Aryanbrb/Specter/LICENSING.md

# Dolivo licensing

Copyright 2026 the Dolivo (formerly Specter) contributors. Source location: https://github.com/Aryanbrb/Specter

Dolivo's original hardware design sources, including the KiCad schematic, PCB, project configuration, original footprint geometry and hardware design data in the BOM, are licensed under [CERN Open Hardware Licence Version 2 – Weakly Reciprocal](LICENSES/CERN-OHL-W-2.0.txt) (SPDX identifier `CERN-OHL-W-2.0`). This licence permits making, modifying and selling products. When distributing covered modifications or products, follow the licence's notice and source-availability terms. Preserve this notice with redistributed source.

Dolivo's original explanatory material, including the README, release checklist, assembly notes and BOM commentary, is licensed under [Creative Commons Attribution 4.0 International](LICENSES/CC-BY-4.0.txt) (SPDX identifier `CC-BY-4.0`). Credit the Dolivo contributors, link to the source and licence, and indicate changes.

## Third-party material

- The two STEP models in [3dmodels](3dmodels/README.md) come from Raspberry Pi's RP2350B Minimal reference design and retain its [MIT licence and disclaimer](3dmodels/LICENSE-Raspberry-Pi.txt).
- KiCad library data embedded in the design retains the [KiCad library licence and design exception](https://www.kicad.org/libraries/license/). Review separately distributed library items for upstream notices.
- The RP2350B, flash, PSRAM and other purchased parts are third-party components. Dolivo's hardware grant covers the module design the contributors control. Supplier datasheets, marks and underlying chip designs remain with their respective owners.
- No Dolivo firmware is included in this revision. Identify the software licence, dependencies and build instructions when introducing firmware.
