Aryanbrb/Specter/3dmodels/abracon_aota-b201610s3r3-101-t.step

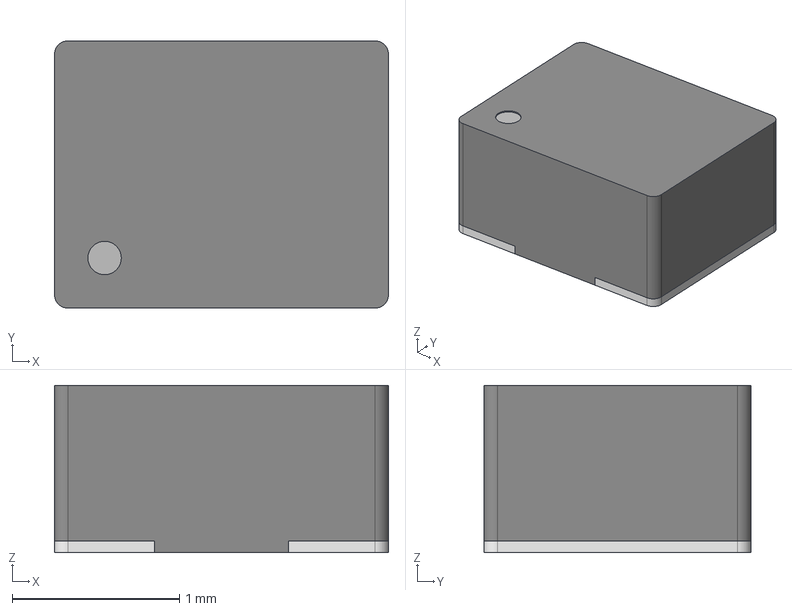
[picture p1: CAD file, 2026-11-12]
3dmodels/abracon_aota-b201610s3r3-101-t.step
2.00 x 1.60 x 1.00 mm
Pins
Pin1Indicator
