Aryanbrb/Specter/3dmodels/rpi_rp2350b.step

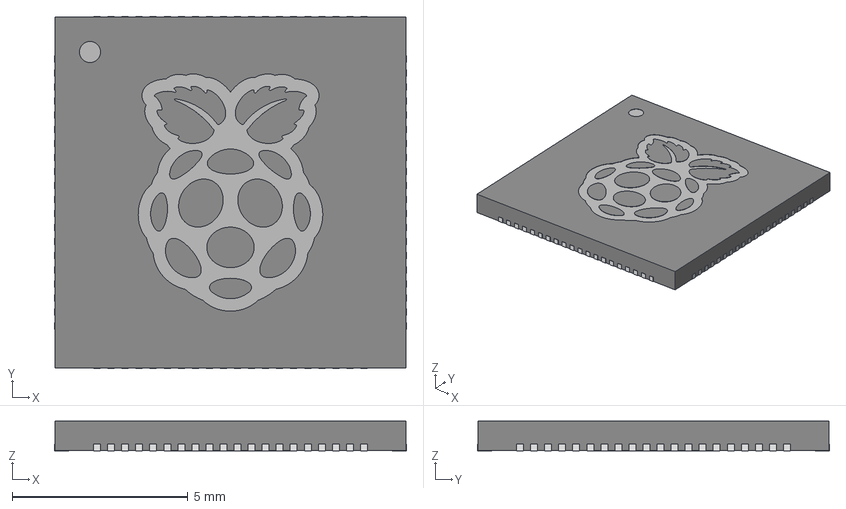
[picture p2: CAD file, 2026-11-12]
3dmodels/rpi_rp2350b.step
10.0 x 10.0 x 0.85 mm
Package
EP
Pin1Indicator
Pins
Logo
