Aryanbrb/Specter/Dolivo.kicad_pcb

## KiCad design Dolivo.kicad_pcb (2026-11-12)

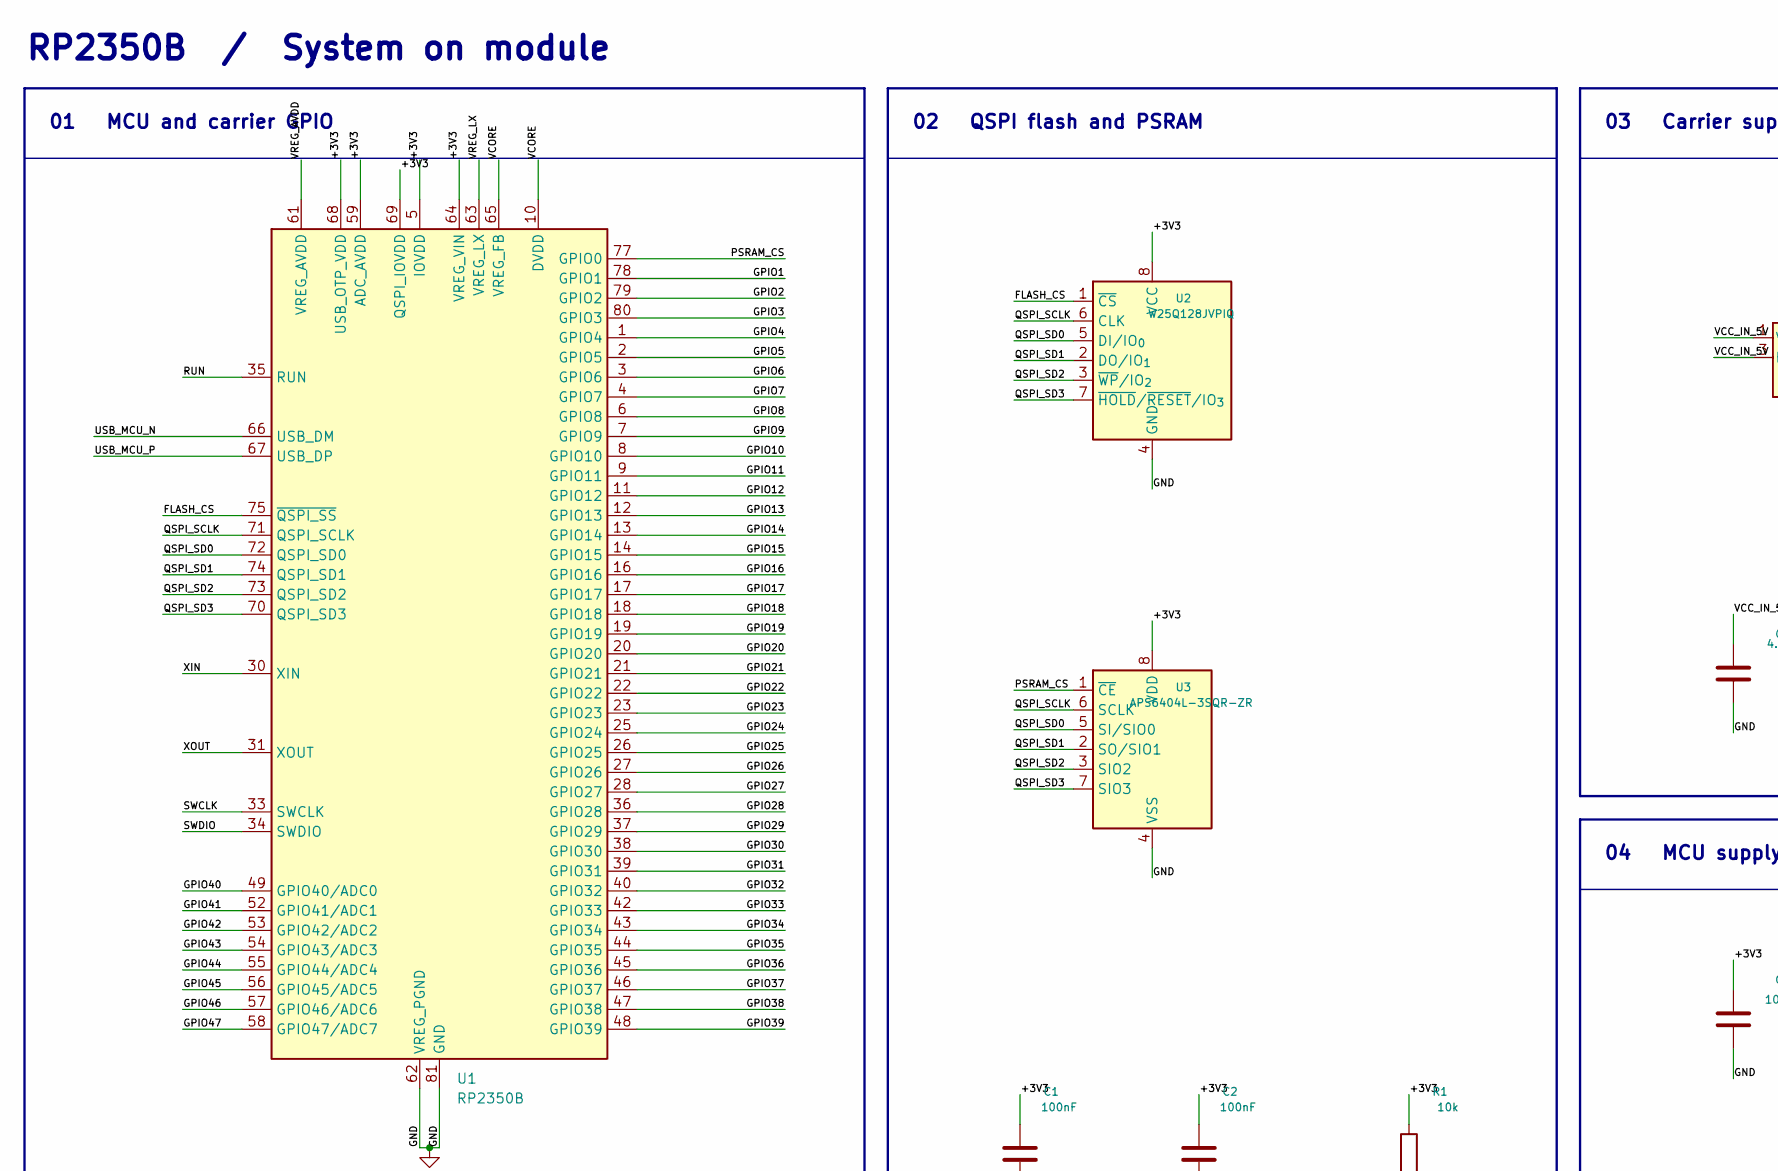
[picture p3: schematic Dolivo.kicad_sch, Dolivo RP2350B SoM, part in row 1, column 1]

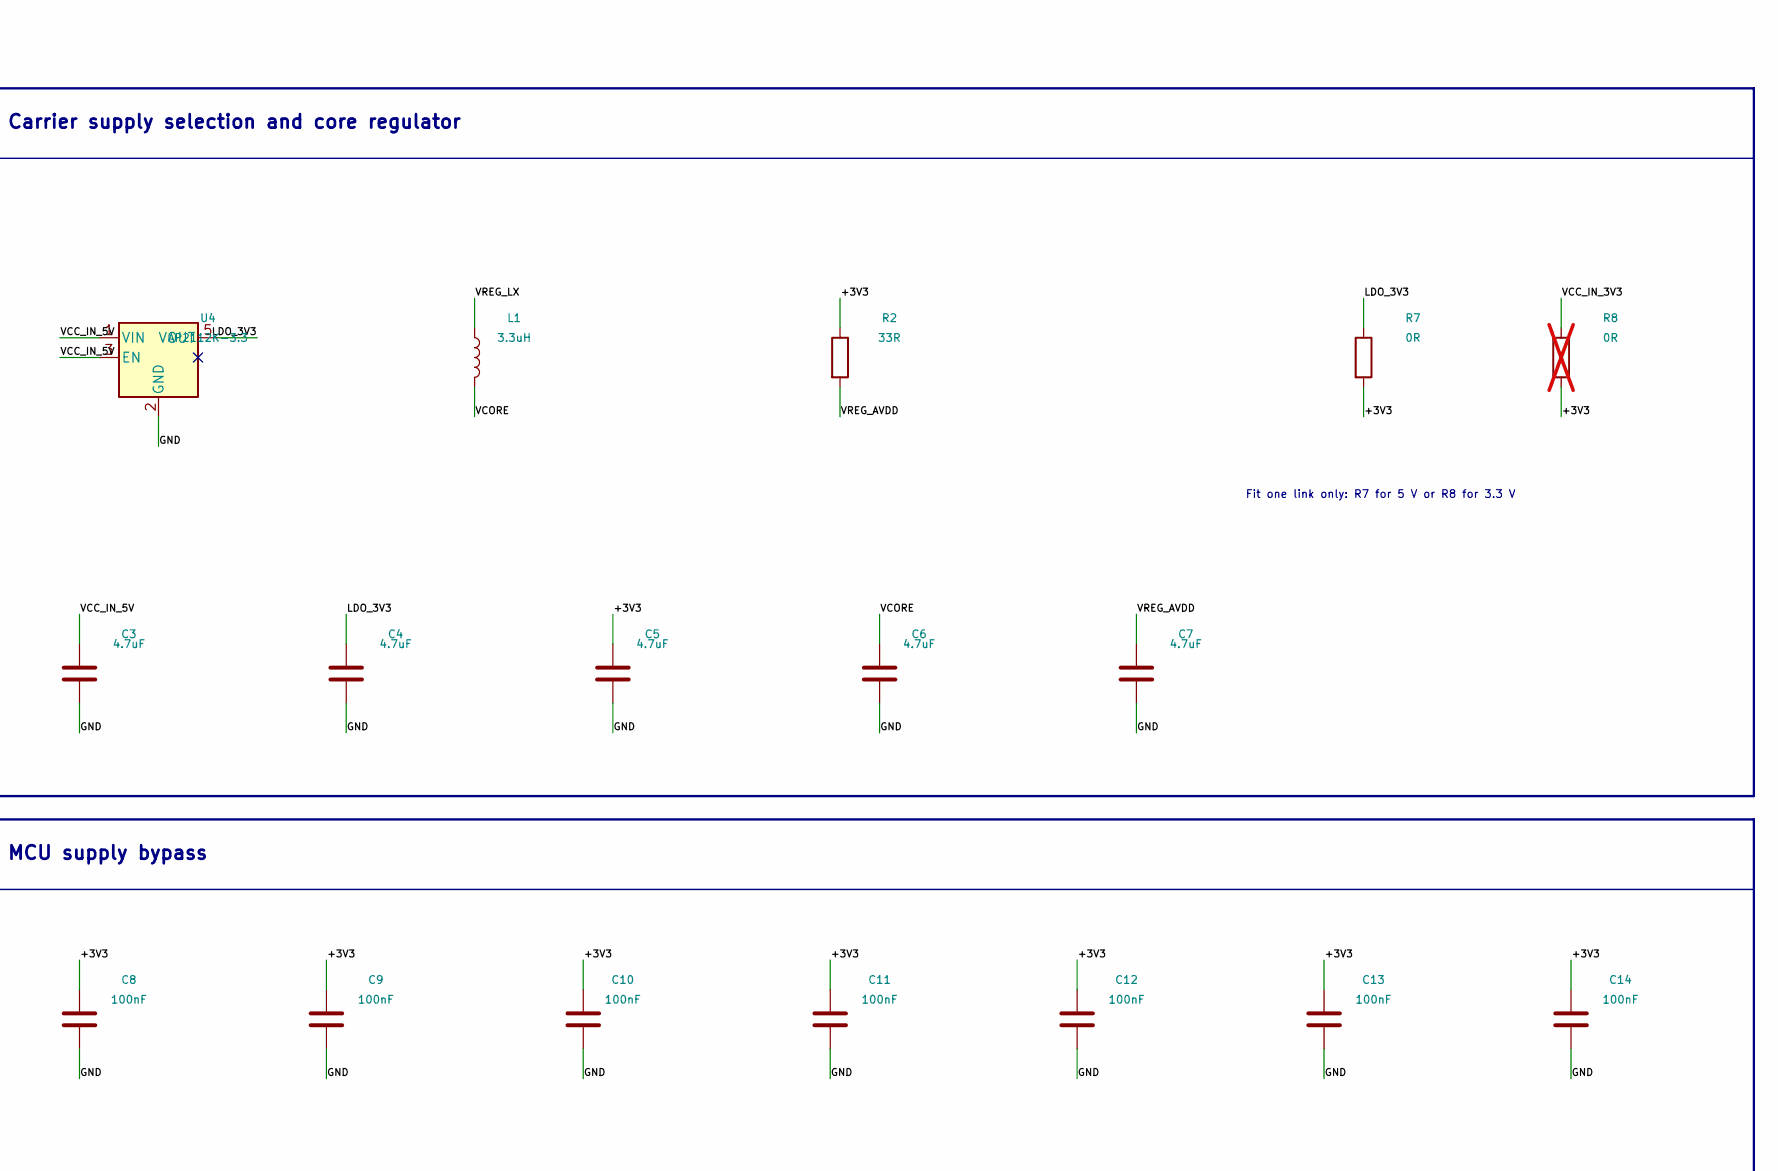
[picture p4: schematic Dolivo.kicad_sch, Dolivo RP2350B SoM, part in row 1, column 2]

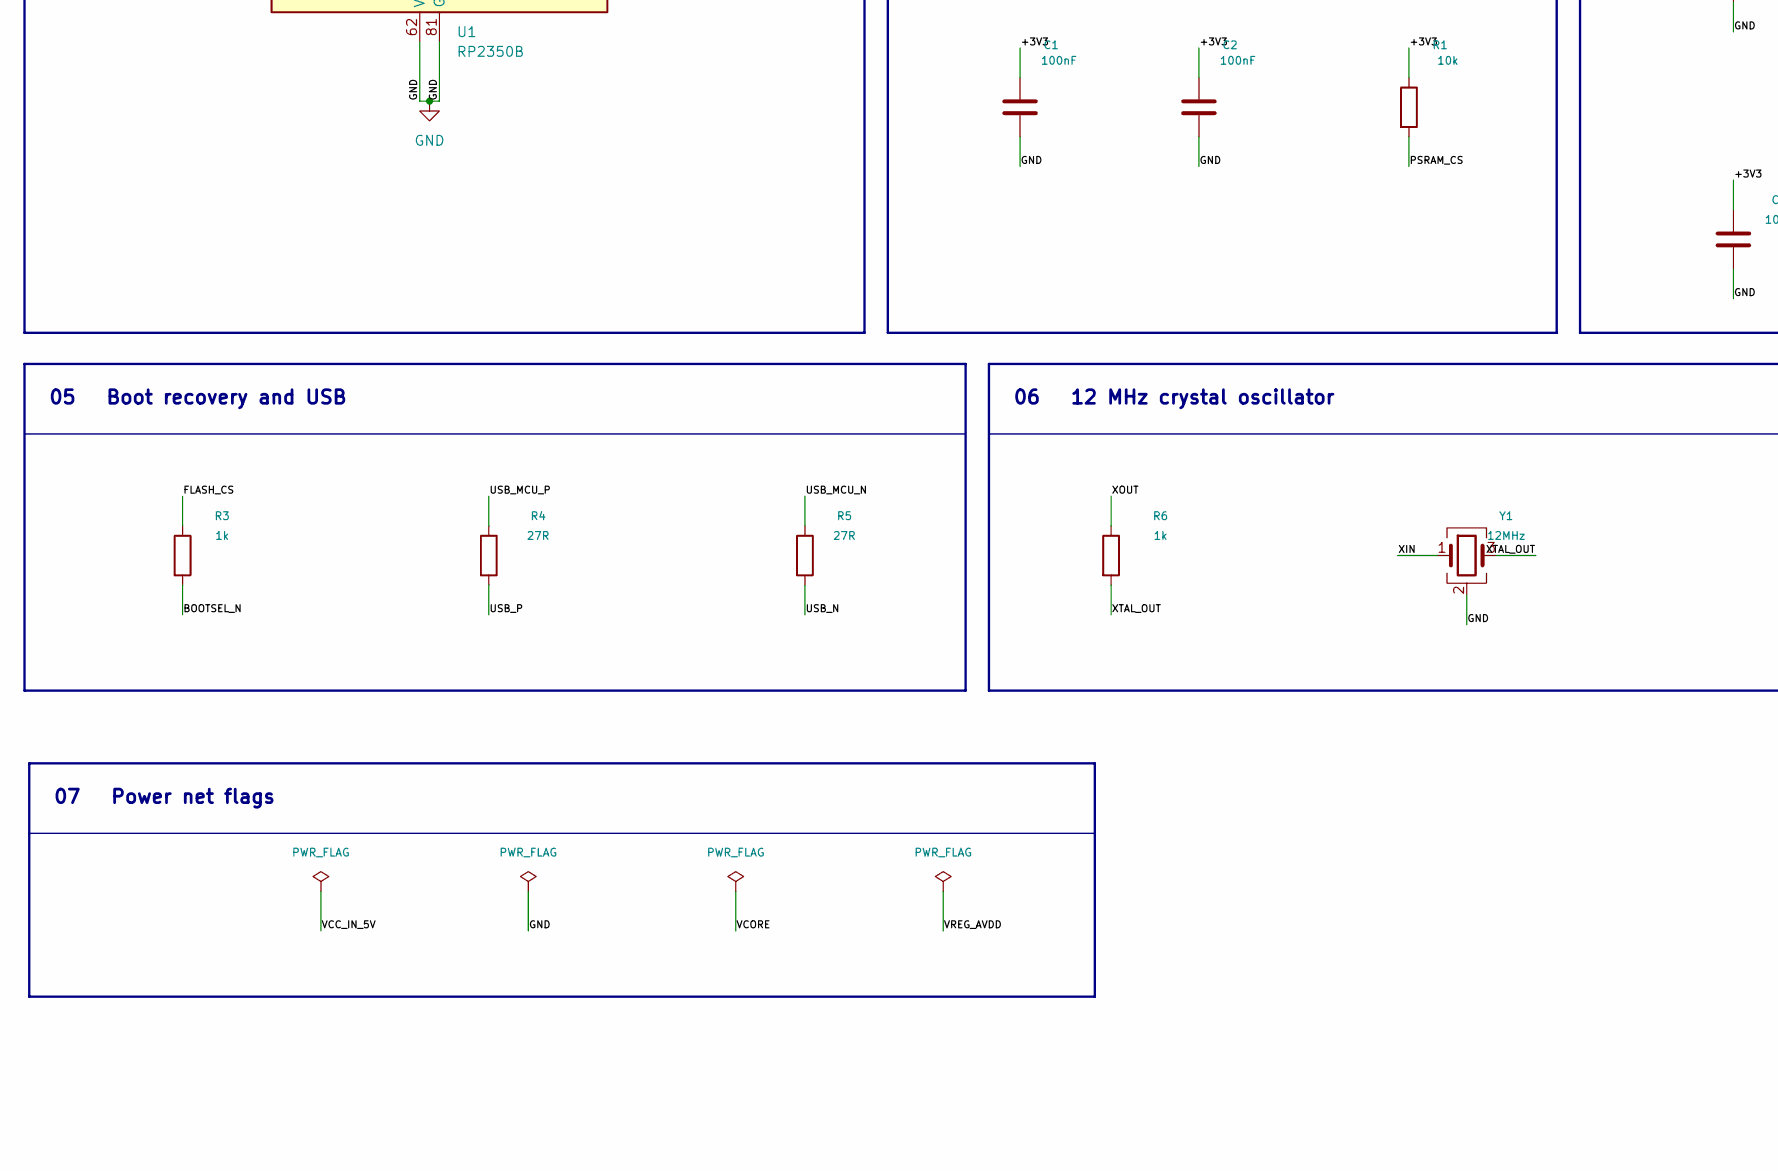
[picture p5: schematic Dolivo.kicad_sch, Dolivo RP2350B SoM, part in row 2, column 1]

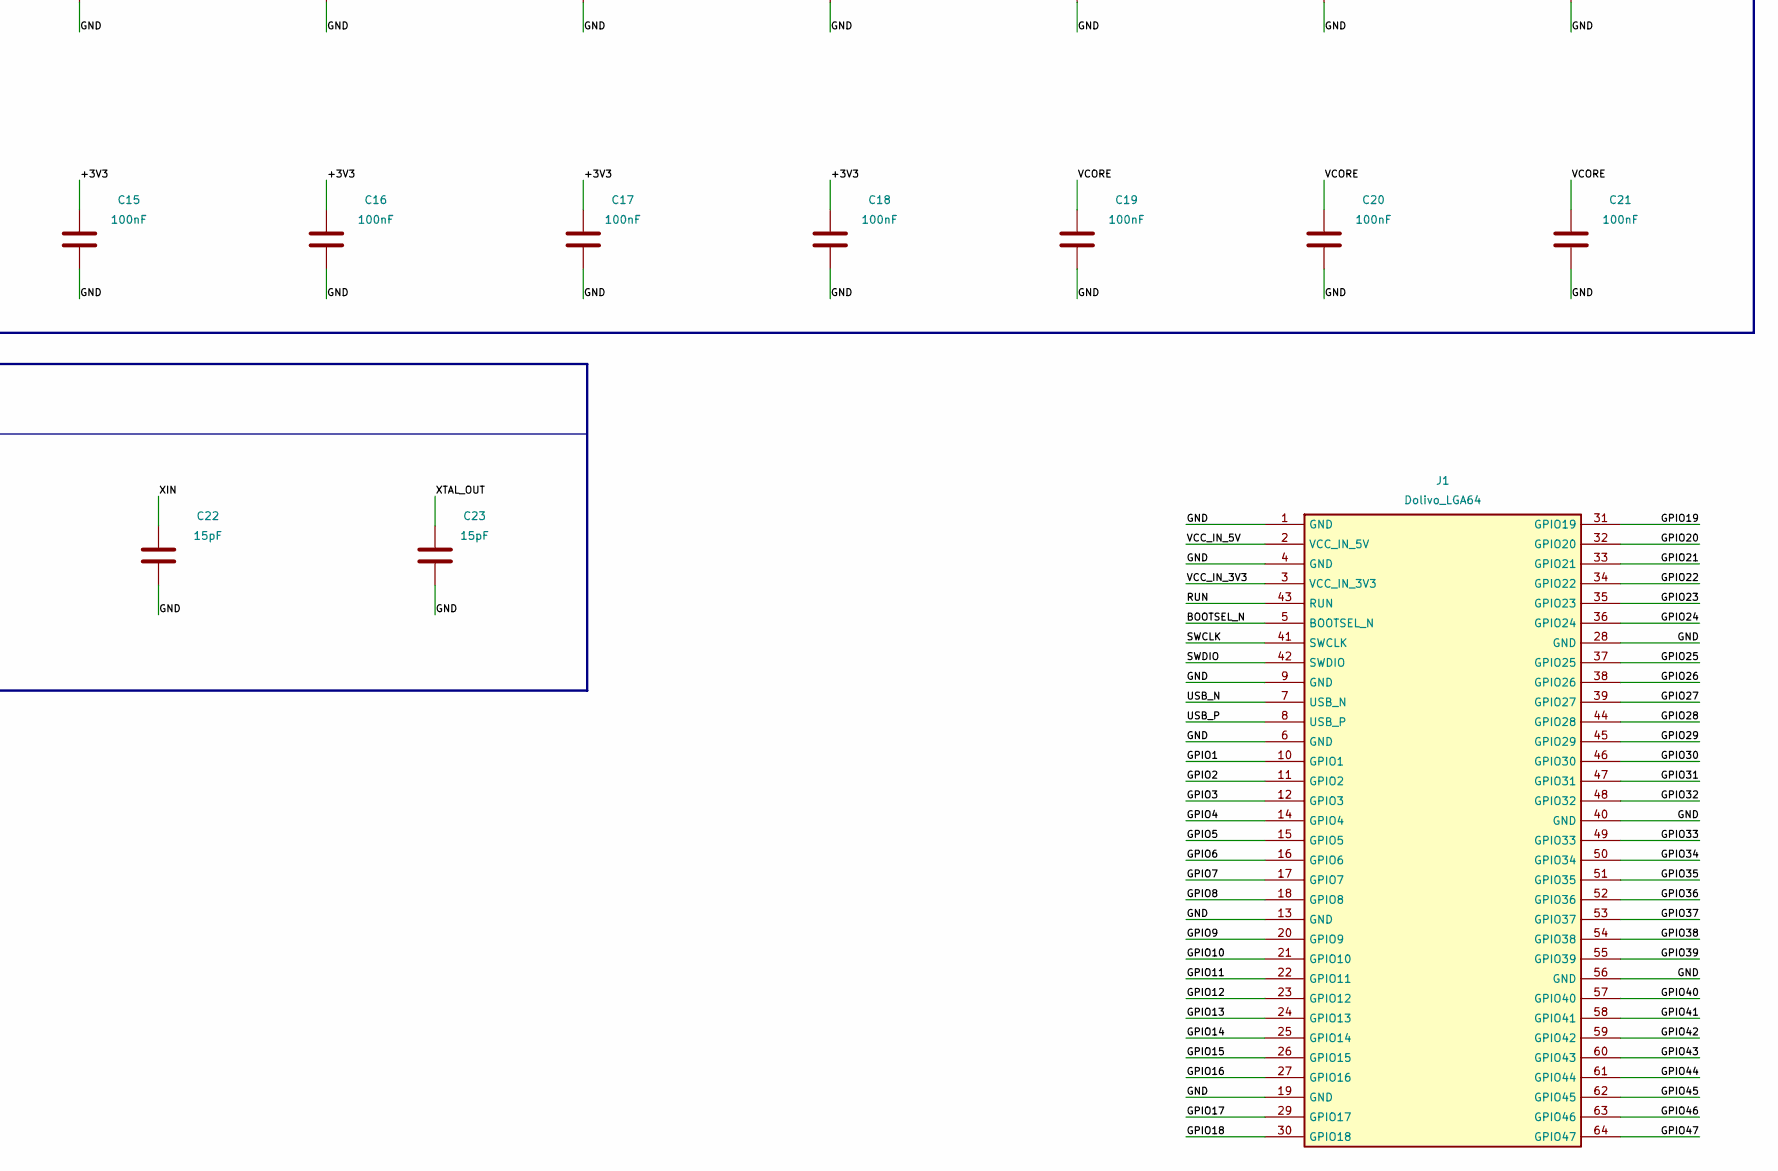
[picture p6: schematic Dolivo.kicad_sch, Dolivo RP2350B SoM, part in row 2, column 2]

Parts:
C1, C2, C8, C9, C10, C11, C12, C13, C14, C15, C16, C17, C18, C19, C20, C21: 100nF; C_0402_1005Metric; MPN CC0402KRX7R7BB104
C3, C4, C5, C6, C7: 4.7uF; C_0402_1005Metric; MPN GRM155R61A475MEAAD
C22, C23: 15pF; C_0402_1005Metric; MPN CC0402JRNPO9BN150
J1: Dolivo_LGA64; Dolivo_LGA64_Module
L1: 3.3uH; AOTA-B201610S3R3-101-T; MPN AOTA-B201610S3R3-101-T
R1: 10k; R_0402_1005Metric; MPN RC0402FR-0710KL
R2: 33R; R_0402_1005Metric; MPN RC0402FR-0733RL
R3, R6: 1k; R_0402_1005Metric; MPN RC0402FR-071KL
R4, R5: 27R; R_0402_1005Metric; MPN RC0402FR-0727RL
R7: 0R; R_0402_1005Metric; MPN RC0402JR-070RL
R8: 0R; R_0402_1005Metric; MPN RC0402JR-070RL; not fitted
U1: RP2350B; QFN-80-1EP_10x10mm_P0.4mm_EP3.4x3.4mm
U2: W25Q128JVPIQ; WSON-8-1EP_6x5mm_P1.27mm_EP3.4x4.3mm; MPN W25Q128JVPIQ
U3: APS6404L-3SQR-ZR; Winbond_USON-8-1EP_3x2mm_P0.5mm_EP0.2x1.6mm; MPN APS6404L-3SQR-ZR
U4: AP2112K-3.3; SOT-23-5; MPN AP2112K-3.3TRG1
Y1: 12MHz; Crystal_SMD_3225-4Pin_3.2x2.5mm; MPN ABM8-272-T3

Connections:
/+3V3: C1.1, C2.1, C5.1, C8.1, C9.1, C10.1, C11.1, C12.1, C13.1, C14.1, C15.1, C16.1, C17.1, C18.1, R1.1, R2.1, R7.2, R8.2, U1.5 (IOVDD), U1.15 (IOVDD), U1.24 (IOVDD), U1.29 (IOVDD), U1.41 (IOVDD), U1.50 (IOVDD), U1.59 (ADC_AVDD), U1.60 (IOVDD), U1.64 (VREG_VIN), U1.68 (USB_OTP_VDD), U1.69 (QSPI_IOVDD), U1.76 (IOVDD), U2.8 (VCC), U3.8 (VDD)
/BOOTSEL_N: J1.5 (RUN), R3.2
/FLASH_CS: R3.1, U1.75 (~QSPI_SS), U2.1 (~CS)
/GPIO1: J1.10 (USB_DM), U1.78 (GPIO1)
/GPIO2: J1.11 (USB_DP), U1.79 (GPIO2)
/GPIO3: J1.12 (GND), U1.80 (GPIO3)
/GPIO4: J1.14 (GPIO2), U1.1 (GPIO4)
/GPIO5: J1.15 (GPIO3), U1.2 (GPIO5)
/GPIO6: J1.16 (GPIO4), U1.3 (GPIO6)
/GPIO7: J1.17 (GPIO5), U1.4 (GPIO7)
/GPIO8: J1.18 (GPIO6), U1.6 (GPIO8)
/GPIO9: J1.20 (GPIO8), U1.7 (GPIO9)
/GPIO10: J1.21 (GND), U1.8 (GPIO10)
/GPIO11: J1.22 (GPIO9), U1.9 (GPIO11)
/GPIO12: J1.23 (GPIO10), U1.11 (GPIO12)
/GPIO13: J1.24 (GPIO11), U1.12 (GPIO13)
/GPIO14: J1.25 (GPIO12), U1.13 (GPIO14)
/GPIO15: J1.26 (GPIO13), U1.14 (GPIO15)
/GPIO16: J1.27 (GPIO14), U1.16 (GPIO16)
/GPIO17: J1.29 (GPIO16), U1.17 (GPIO17)
/GPIO18: J1.30 (GND), U1.18 (GPIO18)
/GPIO19: J1.31 (GPIO17), U1.19 (GPIO19)
/GPIO20: J1.32 (GPIO18), U1.20 (GPIO20)
/GPIO21: J1.33 (GPIO19), U1.21 (GPIO21)
/GPIO22: J1.34 (GPIO20), U1.22 (GPIO22)
/GPIO23: J1.35 (GPIO21), U1.23 (GPIO23)
/GPIO24: J1.36 (GPIO22), U1.25 (GPIO24)
/GPIO25: J1.37 (GPIO23), U1.26 (GPIO25)
/GPIO26: J1.38 (GPIO24), U1.27 (GPIO26)
/GPIO27: J1.39 (GND), U1.28 (GPIO27)
/GPIO28: J1.44 (GPIO29), U1.36 (GPIO28)
/GPIO29: J1.45 (GPIO30), U1.37 (GPIO29)
/GPIO30: J1.46 (GPIO31), U1.38 (GPIO30)
/GPIO31: J1.47 (GPIO32), U1.39 (GPIO31)
/GPIO32: J1.48 (GND), U1.40 (GPIO32)
/GPIO33: J1.49 (GPIO33), U1.42 (GPIO33)
/GPIO34: J1.50 (GPIO34), U1.43 (GPIO34)
/GPIO35: J1.51 (GPIO35), U1.44 (GPIO35)
/GPIO36: J1.52 (GPIO36), U1.45 (GPIO36)
/GPIO37: J1.53 (GPIO37), U1.46 (GPIO37)
/GPIO38: J1.54 (GPIO38), U1.47 (GPIO38)
/GPIO39: J1.55 (GPIO39), U1.48 (GPIO39)
/GPIO40: J1.57 (GPIO40), U1.49 (GPIO40/ADC0)
/GPIO41: J1.58 (GPIO41), U1.52 (GPIO41/ADC1)
/GPIO42: J1.59 (GPIO42), U1.53 (GPIO42/ADC2)
/GPIO43: J1.60 (GPIO43), U1.54 (GPIO43/ADC3)
/GPIO44: J1.61 (GPIO44), U1.55 (GPIO44/ADC4)
/GPIO45: J1.62 (GPIO45), U1.56 (GPIO45/ADC5)
/GPIO46: J1.63 (GPIO46), U1.57 (GPIO46/ADC6)
/GPIO47: J1.64 (GPIO47), U1.58 (GPIO47/ADC7)
/LDO_3V3: C4.1, R7.1, U4.5 (VOUT)
/PSRAM_CS: R1.2, U1.77 (GPIO0), U3.1 (~CE)
/QSPI_SCLK: U1.71 (QSPI_SCLK), U2.6 (CLK), U3.6 (SCLK)
/QSPI_SD0: U1.72 (QSPI_SD0), U2.5 (DI/IO_{0}), U3.5 (SI/SIO0)
/QSPI_SD1: U1.74 (QSPI_SD1), U2.2 (DO/IO_{1}), U3.2 (SO/SIO1)
/QSPI_SD2: U1.73 (QSPI_SD2), U2.3 (~WP/IO_{2}), U3.3 (SIO2)
/QSPI_SD3: U1.70 (QSPI_SD3), U2.7 (~HOLD/~RESET/IO_{3}), U3.7 (SIO3)
/RUN: J1.43 (GPIO28), U1.35 (RUN)
/SWCLK: J1.41 (GPIO26), U1.33 (SWCLK)
/SWDIO: J1.42 (GPIO27), U1.34 (SWDIO)
/USB_MCU_N: R5.1, U1.66 (USB_DM)
/USB_MCU_P: R4.1, U1.67 (USB_DP)
/USB_N: J1.7 (SWCLK), R5.2
/USB_P: J1.8 (SWDIO), R4.2
/VCC_IN_3V3: J1.3 (GND), R8.1
/VCC_IN_5V: C3.1, J1.2 (VCC_IN_5V), U4.1 (VIN), U4.3 (EN)
/VCORE: C6.1, C19.1, C20.1, C21.1, L1.2, U1.10 (DVDD), U1.32 (DVDD), U1.51 (DVDD), U1.65 (VREG_FB)
/VREG_AVDD: C7.1, R2.2, U1.61 (VREG_AVDD)
/VREG_LX: L1.1, U1.63 (VREG_LX)
/XIN: C22.1, U1.30 (XIN), Y1.1
/XOUT: R6.1, U1.31 (XOUT)
/XTAL_OUT: C23.1, R6.2, Y1.3
GND: C1.2, C2.2, C3.2, C4.2, C5.2, C6.2, C7.2, C8.2, C9.2, C10.2, C11.2, C12.2, C13.2, C14.2, C15.2, C16.2, C17.2, C18.2, C19.2, C20.2, C21.2, C22.2, C23.2, J1.1 (GND), J1.4 (VCC_IN_3V3), J1.6 (BOOTSEL_N), J1.9 (GND), J1.13 (GPIO1), J1.19 (GPIO7), J1.28 (GPIO15), J1.40 (GPIO25), J1.56 (GND), U1.62 (VREG_PGND), U1.81 (GND), U2.4 (GND), U3.4 (VSS), U4.2 (GND), Y1.2 (G), Y1.4 (G)

Notes on the sheet:
RP2350B / System on module
06 12 MHz crystal oscillator
04 MCU supply bypass
03 Carrier supply selection and core regulator
07 Power net flags
05 Boot recovery and USB
01 MCU and carrier GPIO
02 QSPI flash and PSRAM
Fit one link only: R7 for 5 V or R8 for 3.3 V

Board: 4 copper layers, 38 parts (0 on the bottom side), 73 nets, no tracks yet.
