Aryanbrb/Specter/(commit log)

2026-11-02 Add Specter RP2350B module design and prototype BOM
    [RP2350 SoM.kicad_pcb, RP2350 SoM.kicad_sch]
2026-11-02 Made custom footprint and symbol for SOM
    [RP2350 SoM.kicad_pcb]
2026-11-02 PCB Placement started
    [RP2350 SoM.kicad_pcb, RP2350 SoM.kicad_sch]
2026-11-10 Placement done
    [RP2350 SoM.kicad_pcb, RP2350 SoM.kicad_sch]
2026-11-12 Placement and SoM Layout
    [RP2350 SoM.kicad_pcb, RP2350 SoM.kicad_sch, abracon_aota-b201610s3r3-101-t.step, rpi_rp2350b.step]
2026-11-12 Project name changed
    [Dolivo.kicad_pcb, Dolivo.kicad_sch]
